drogue-iot/burrboard/hardware/feather/burrboard_back.png

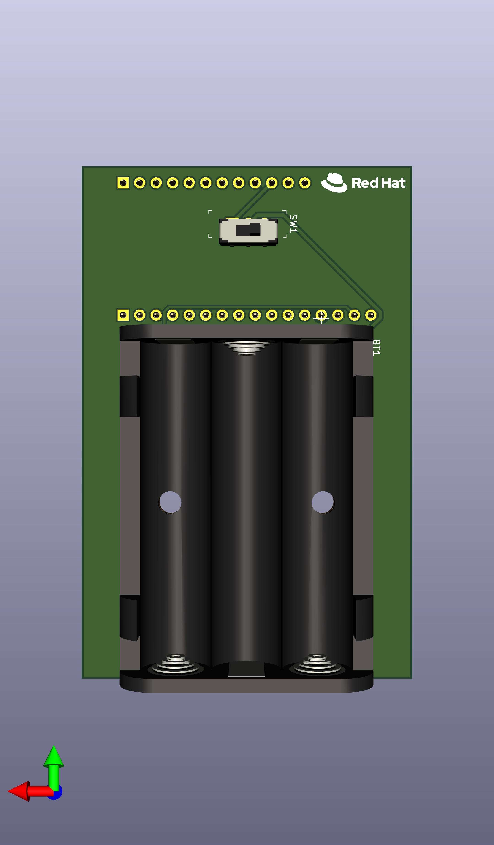
hardware/feather/burrboard_back.png
