drogue-iot/burrboard/hardware/feather/burrboard_front.png

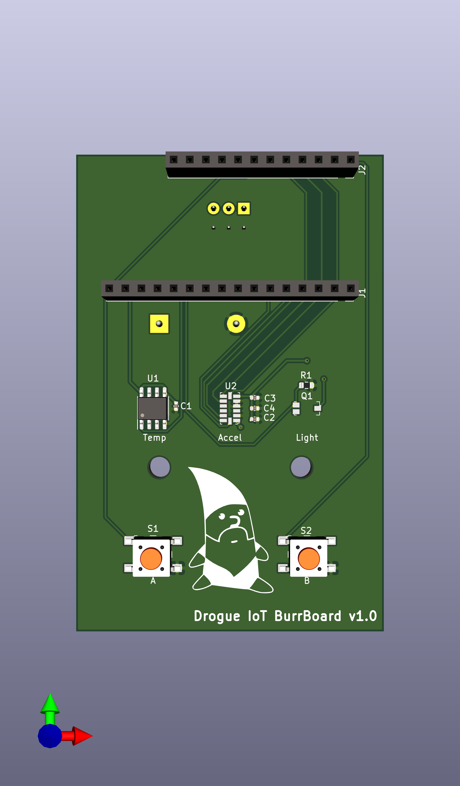
hardware/feather/burrboard_front.png
