drogue-iot/burrboard/README.md

# burrboard

This repository contains prototyping boards for RH summit, aka burrboards, firmware running on the
burrboard feathers, and the software around it
