drogue-iot/burrboard/digital-twin/README.md

# Cheatsheet

## Creating devices (for the simulator)

Requires drg >= 0.8.1 (alpha1)

```shell
drg create device -a ctron-test-ditto device1
drg set password -a ctron-test-ditto foobar1 device1
drg label device -a device1 ditto=true
```

Create a list of devices:

```shell
for i in $(seq -w 1 10); do
  drg create device -a ctron-test-ditto device$i
  drg set password -a ctron-test-ditto foobar$i device$i
  drg set label -a ctron-test-ditto --device device$i ditto=true
done
```

Delete them again:

```shell
for i in $(seq -w 1 10); do
  drg delete device -a ctron-test-ditto device$i
done
```

## Access data

```shell
USER="someuser"
PASSWORD="abc"
podman run --rm -ti docker.io/bitnami/kafka:latest kafka-console-consumer.sh \
	--topic sensor-events \
	--bootstrap-server kafka-kafka-bootstrap-burrboard.apps.wonderful.iot-playground.org:443 \
	--consumer-property security.protocol=SASL_SSL \
	--consumer-property sasl.mechanism=SCRAM-SHA-512 \
	--consumer-property sasl.jaas.config='org.apache.kafka.common.security.scram.ScramLoginModule required username="${USER}" password="${PASSWORD}";'
```

Also get the headers:

```shell
set TOPIC sensor-events
set USER "foo"
set PASSWORD (oc -n burrboard get secret $USER -o json | jq -r '.data.password' | base64 -d)
podman run --rm -it docker.io/edenhill/kcat:1.7.1 \
	-b kafka-kafka-bootstrap-burrboard.apps.wonderful.iot-playground.org:443 \
	-o end \
	-X security.protocol=SASL_SSL \
	-X sasl.mechanism=SCRAM-SHA-512 \
	-X sasl.username=$USER \
	-X sasl.password=$PASSWORD \
	-f '\nKey (%K bytes): %k
  Value (%S bytes): %s
  Timestamp: %T
  Partition: %p
  Offset: %o
  Headers: %h\n' \
	-G my-kafka-group $TOPIC
```

## Kafka stuff

List consumer groups:

```shell
./bin/kafka-consumer-groups.sh --bootstrap-server kafka-kafka-bootstrap-burrboard.apps.wonderful.iot-playground.org:443 --command-config config.properties --list
./bin/kafka-consumer-groups.sh --bootstrap-server drogue-iot-kafka-bootstrap-drogue-dev.apps.wonderful.iot-playground.org:443 --command-config config2.properties --list
```

Watch consumer groups:
```shell
watch "./bin/kafka-consumer-groups.sh --bootstrap-server kafka-kafka-bootstrap-burrboard.apps.wonderful.iot-playground.org:443 --command-config /home/jreimann/git/burrboard/digital-twin/config.properties --group ditto-reconciler --describe ; ./bin/kafka-consumer-groups.sh --bootstrap-server kafka-kafka-bootstrap-burrboard.apps.wonderful.iot-playground.org:443 --command-config /home/jreimann/git/burrboard/digital-twin/config.properties --group game-controller --describe ; ./bin/kafka-consumer-groups.sh --bootstrap-server drogue-iot-kafka-bootstrap-drogue-dev.apps.wonderful.iot-playground.org:443 --command-config /home/jreimann/git/burrboard/digital-twin/config2.properties --group ditto-kafka-drogue-ctron-test-ditto --describe"
```

## Work with digital twin

Get state:

```shell
set TOKEN (drg whoami -t)
http -v GET https://ditto-drogue-dev.apps.wonderful.iot-playground.org/api/2/things/ctron-test-ditto:device1 "Authorization:Bearer $TOKEN"
```

Request LED state:

```shell
set TOKEN (drg whoami -t)
http -v PUT https://ditto-drogue-dev.apps.wonderful.iot-playground.org/api/2/things/ctron-test-ditto:device1/features/leds "Authorization:Bearer $TOKEN" \
  --raw '{}'
http -v PUT https://ditto-drogue-dev.apps.wonderful.iot-playground.org/api/2/things/ctron-test-ditto:device1/features/leds/desiredProperties/1 "Authorization:Bearer $TOKEN" \
  --raw 'true'
```
