drogue-iot/burrboard/hardware/feather/burrboard.html

# /Users/lulf/dev/burrboard/feather/burrboard.sch

2022 January 07, Friday 11:13:08

Eeschema (5.1.10-1-10_14)

Component Count:14

Ref | Qnty | Value | Part | Datasheet | Description | Vendor
BT1 | 1 | 2479 | Device:Battery | https://www.keyelco.com/userAssets/file/M65p28.pdf | Multiple-cell battery
C1, C4 | 2 | 100.0nF, 0805 SMD | Device:CP1 | ~ | Polarized capacitor, US symbol
C2 | 1 | 10.0µF, 0805 SMD | Device:CP1 | ~ | Polarized capacitor, US symbol
C3 | 1 | 100.0nF, 0805 SMD | Device:CP1 | ~ | Polarized capacitor, US symbol
J1 | 1 | M20-7821642 | Connector_Generic:Conn_01x16 | ~ | Generic connector, single row, 01x16, script generated (kicad-library-utils/schlib/autogen/connector/)
J2 | 1 | M20-7821242 | Connector_Generic:Conn_01x12 | ~ | Generic connector, single row, 01x12, script generated (kicad-library-utils/schlib/autogen/connector/)
Q1 | 1 | TEMT6000X01 | dk_Optical-Sensors-Phototransistors:TEMT6000X01 | http://www.vishay.com/docs/81579/temt6000.pdf | SENSOR PHOTO 570NM TOP VIEW 1206
R1 | 1 | Resistor, 10.0kΩ, 0805 SMD | Device:R | ~ | Resistor
S1, S2 | 2 | PTS645SH43SMTR92LFS | dk_Tactile-Switches:PTS645SM43SMTR92_LFS | https://www.ckswitches.com/media/1471/pts645.pdf | SWITCH TACTILE SPST-NO 0.05A 12V
S3 | 1 | JS202011SCQN | burrboard:JS202011SCQN | https://www.ckswitches.com/media/1422/js.pdf | SWITCH SLIDE DPDT 300MA 6V
U1 | 1 | TMP36GSZ | Sensor_Temperature:TMP36xS | https://www.analog.com/media/en/technical-documentation/data-sheets/TMP35_36_37.pdf | Low Voltage Temperature Sensor, SOIC-8
U2 | 1 | ADXL345BCCZ | dk_Motion-Sensors-Accelerometers:ADXL345BCCZ | https://www.analog.com/media/en/technical-documentation/data-sheets/ADXL345.pdf | ACCEL 2-16G I2C/SPI 14LGA
