drogue-iot/burrboard/hardware/microbit/burrboard.html

# /Users/lulf/dev/burrboard/burrboard.sch

2021 December 20, Monday 12:28:43

Eeschema (5.1.10-1-10_14)

Component Count:14

Ref | Qnty | Value | Part | Datasheet | Description | Vendor
BT1, BT2, BT3 | 3 | Battery_Cell | Device:Battery_Cell | ~ | Single-cell battery
J1 | 1 | 22-23-2021 | dk_Rectangular-Connectors-Headers-Male-Pins:22-23-2021 | https://media.digikey.com/pdf/Data%20Sheets/Molex%20PDFs/A-6373-N_Series_Dwg_2010-12-03.pdf | CONN HEADER VERT 2POS 2.54MM
J2 | 1 | microbit_edge_connector | microbit_edge_connector:microbit_edge_connector | https://www.microbit.co.uk/device/pins | micro:bit vertial edge connector
J3 | 1 | TEMP | Connector_Generic:Conn_01x01 | ~ | Generic connector, single row, 01x01, script generated (kicad-library-utils/schlib/autogen/connector/)
J4 | 1 | SPI | Connector_Generic:Conn_01x03 | ~ | Generic connector, single row, 01x03, script generated (kicad-library-utils/schlib/autogen/connector/)
J5 | 1 | Light | Connector_Generic:Conn_01x01 | ~ | Generic connector, single row, 01x01, script generated (kicad-library-utils/schlib/autogen/connector/)
J6 | 1 | Power | Connector_Generic:Conn_02x02_Top_Bottom | ~ | Generic connector, double row, 02x02, top/bottom pin numbering scheme (row 1: 1...pins_per_row, row2: pins_per_row+1 ... num_pins), script generated (kicad-library-utils/schlib/autogen/connector/)
J7 | 1 | Conn_01x06 | Connector_Generic:Conn_01x06 | ~ | Generic connector, single row, 01x06, script generated (kicad-library-utils/schlib/autogen/connector/)
J8 | 1 | I2C | Connector_Generic:Conn_01x02 | ~ | Generic connector, single row, 01x02, script generated (kicad-library-utils/schlib/autogen/connector/)
Q1 | 1 | Q_Photo_NPN | Device:Q_Photo_NPN | ~ | NPN phototransistor, collector/emitter
R1 | 1 | 2k | Device:R | ~ | Resistor
U1 | 1 | TMP36GT9Z | dk_Temperature-Sensors-Analog-and-Digital-Output:TMP36GT9Z | https://www.analog.com/media/en/technical-documentation/data-sheets/TMP35_36_37.pdf | SENSOR ANALOG -40C-125C TO92-3
