drogue-iot/burrboard/hardware/back.png

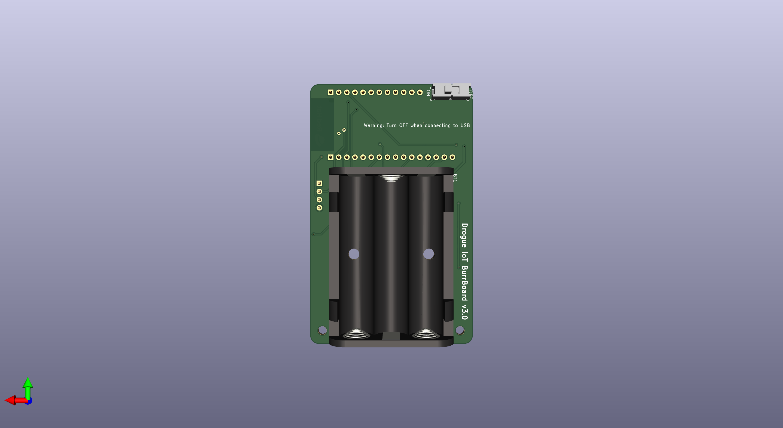
hardware/back.png
