drogue-iot/burrboard/hardware/redhat.png

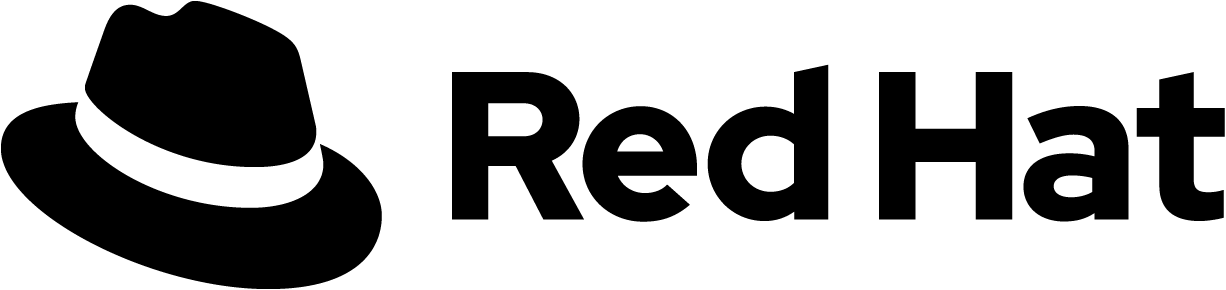
hardware/redhat.png
