drogue-iot/burrboard/hardware/side.png

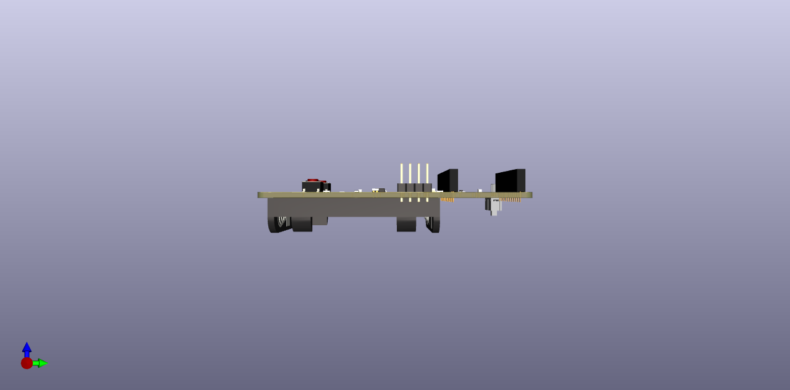
hardware/side.png
