drogue-iot/burrboard/hardware/feather/3dmodels/ADXL345BCCZ-RL7.stp

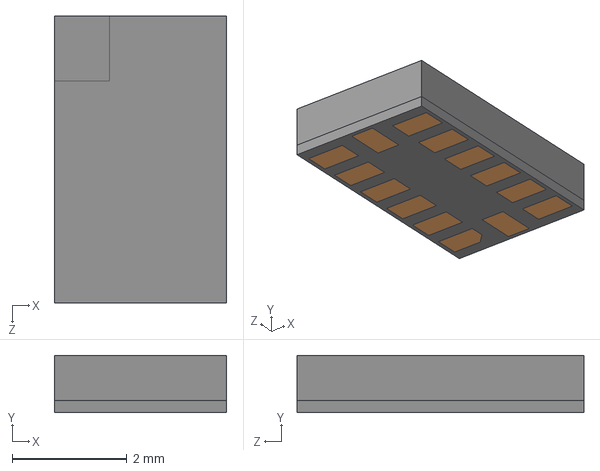
[picture p6: CAD file, 2022-02-15]
hardware/feather/3dmodels/ADXL345BCCZ-RL7.stp
3.00 x 1.00 x 5.00 mm
