drogue-iot/burrboard/hardware/feather/3dmodels/TEMT6000X01.stp

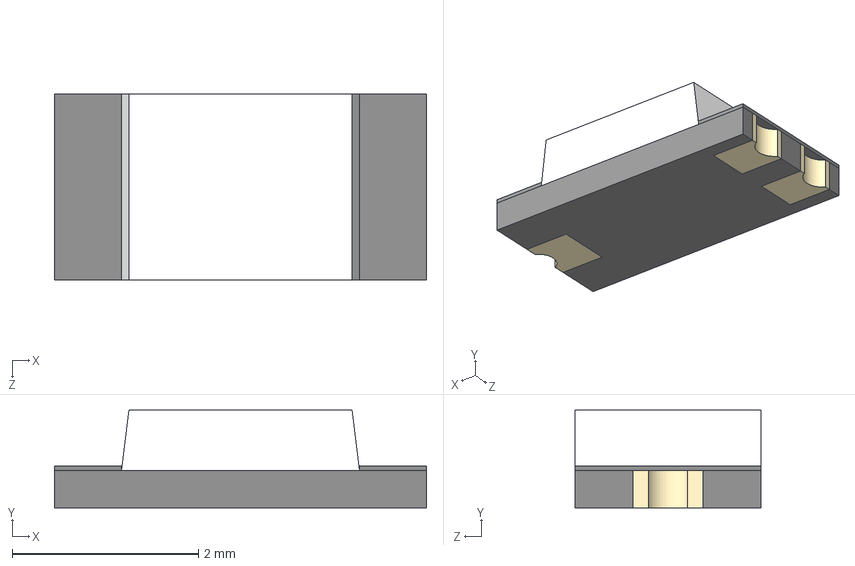
[picture p7: CAD file, 2022-02-02]
hardware/feather/3dmodels/TEMT6000X01.stp
4.00 x 1.05 x 2.00 mm
