drogue-iot/burrboard/hardware/feather/3dmodels/EG1218--3DModel-STEP-520916.STEP

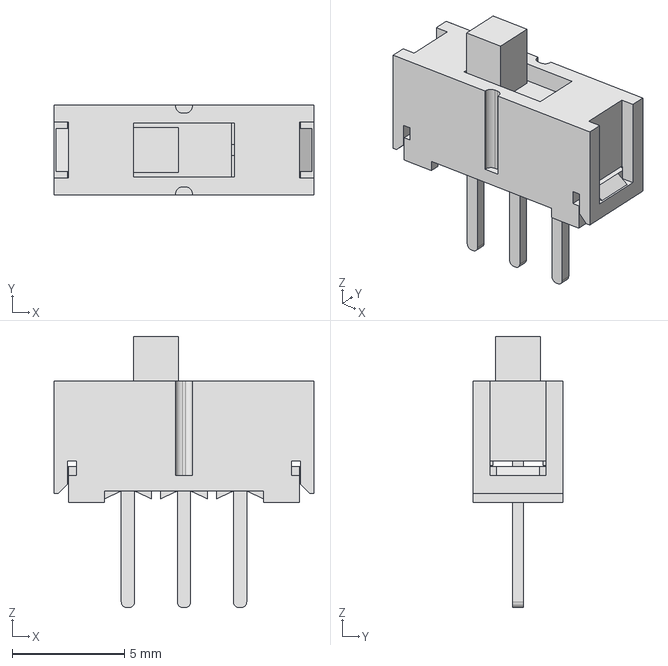
[picture p8: CAD file, 2022-02-02]
hardware/feather/3dmodels/EG1218--3DModel-STEP-520916.STEP
11.6 x 4.00 x 12.1 mm
