drogue-iot/burrboard/hardware/feather/assembly_drawings/3d_back.png

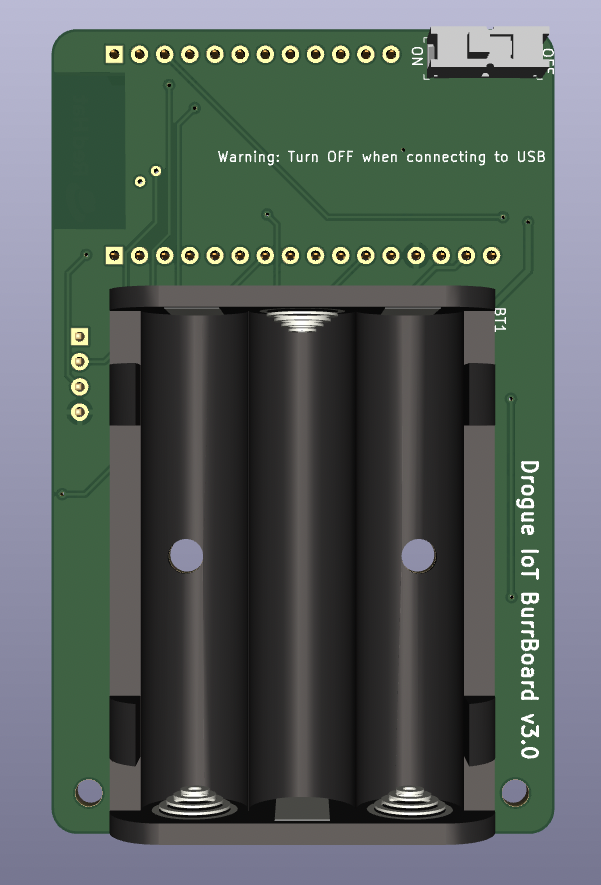
hardware/feather/assembly_drawings/3d_back.png
