drogue-iot/burrboard/hardware/feather/assembly_drawings/3d_front.png

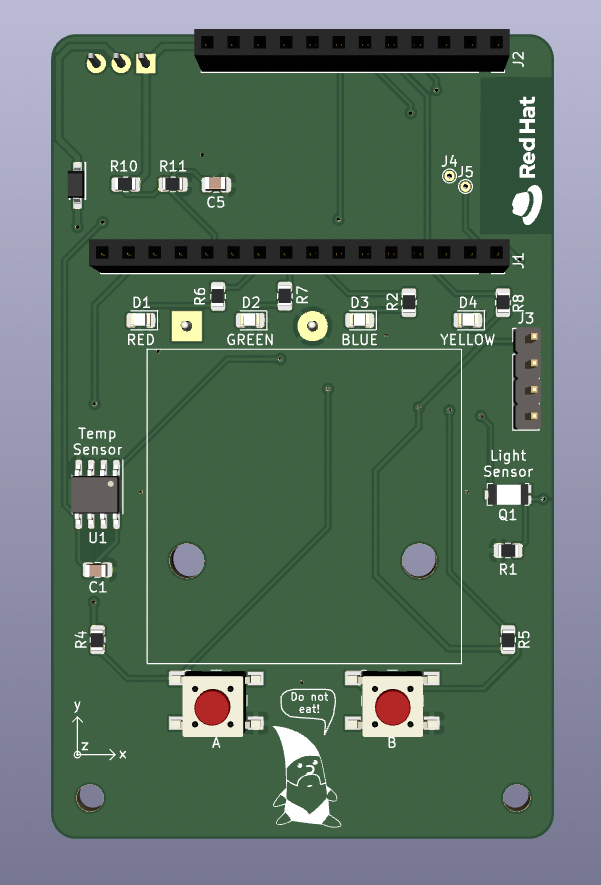
hardware/feather/assembly_drawings/3d_front.png
