drogue-iot/burrboard/hardware/feather/assembly_drawings/assembly_drawing.pdf

## Front Side

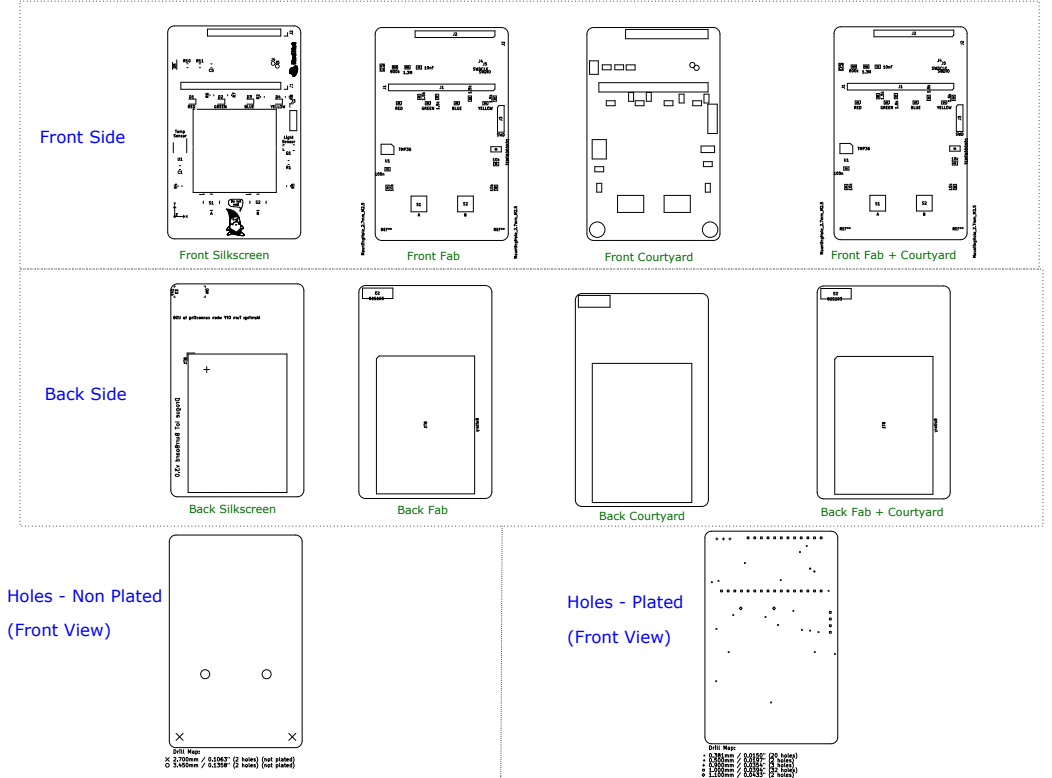
[picture p11: page 1]
Front Silkscreen; Front Fab; Front Courtyard; Front Fab + Courtyard; Back Silkscreen; Back Side; Holes - Plated; (Front View); Back Fab; Back Courtyard; Back Fab + Courtyard

Holes - Non Plated
(Front View)
