drogue-iot/burrboard/(commit log)

2022-01-03 Initial import
    [burrboard.kicad_pcb, burrboard.sch]
2022-01-03 Use AAA holder
    [burrboard.sch]
2022-01-03 Update capacitor dimensions
    [burrboard.sch]
2022-01-03 Add new footprint
2022-01-03 ADd footprint for 40p microbit connector SMD mount
2022-01-04 Add feather variant
    [burrboard.kicad_pcb, burrboard.sch]
2022-01-04 Add new phototransistor and button
    [burrboard.sch]
2022-01-04 Use THT transistor in prototype
    [burrboard.sch]
2022-01-04 Add initial pcb layout
    [burrboard.kicad_pcb, burrboard.sch]
2022-01-04 Add layout
    [burrboard.kicad_pcb]
2022-01-04 Add logo
    [burrboard.kicad_pcb]
2022-01-05 Add redhat logo to back silkscreen
    * More place route
    [burrboard.kicad_pcb, burrboard.sch]
2022-01-05 Update to handle battery case
    [burrboard.kicad_pcb, burrboard.sch]
2022-01-05 Place accelerometer on main part
    [burrboard.kicad_pcb, burrboard.sch]
2022-01-05 Layout done
    [burrboard.kicad_pcb, burrboard.sch]
2022-01-05 Add gerber files
    [burrboard-B_Cu.gbl, burrboard-B_Mask.gbs, burrboard-B_SilkS.gbo, burrboard-Edge_Cuts.gm1, burrboard-F_Cu.gtl, burrboard-F_Mask.gts, burrboard-F_SilkS.gto, burrboard-job.gbrjob]
2022-01-05 Update gerbers
    [burrboard-B_Cu.gbl, burrboard-B_Mask.gbs, burrboard-B_SilkS.gbo, burrboard-Edge_Cuts.gm1, burrboard-F_Cu.gtl, burrboard-F_Mask.gts, burrboard-F_SilkS.gto, burrboard-job.gbrjob]
2022-01-05 Update 3d modesl
    [burrboard-B_Cu.gbl, burrboard-B_Mask.gbs, burrboard-B_SilkS.gbo, burrboard-Edge_Cuts.gm1, burrboard-F_Cu.gtl, burrboard-F_Mask.gts, burrboard-F_SilkS.gto, burrboard-job.gbrjob]
2022-01-05 Update part values
    [burrboard.sch]
2022-01-06 Adjust silkscreen
    [burrboard-B_Cu.gbl, burrboard-B_Mask.gbs, burrboard-B_SilkS.gbo, burrboard-Edge_Cuts.gm1, burrboard-F_Cu.gtl, burrboard-F_Mask.gts, burrboard-F_SilkS.gto, burrboard-job.gbrjob]
2022-01-06 Update manufacturer
    [burrboard-B_Cu.gbl, burrboard-B_Mask.gbs, burrboard-B_SilkS.gbo, burrboard-Edge_Cuts.gm1, burrboard-F_Cu.gtl, burrboard-F_Mask.gts, burrboard-F_SilkS.gto, burrboard-job.gbrjob]
2022-01-06 Use larger capacitor and resistor prints
    [burrboard-B_Cu.gbl, burrboard-B_Mask.gbs, burrboard-B_SilkS.gbo, burrboard-Edge_Cuts.gm1, burrboard-F_Cu.gtl, burrboard-F_Mask.gts, burrboard-F_SilkS.gto, burrboard-job.gbrjob]
2022-01-06 Use larger footprints for capacitors and resistors
    [burrboard-B_Cu.gbl, burrboard-B_Mask.gbs, burrboard-B_SilkS.gbo, burrboard-Edge_Cuts.gm1, burrboard-F_Cu.gtl, burrboard-F_Mask.gts, burrboard-F_SilkS.gto, burrboard-job.gbrjob]
2022-01-06 Update specs
    [burrboard.sch]
2022-01-07 Update to use DPDT SMD switch
    [burrboard-B_Cu.gbl, burrboard-B_Mask.gbs, burrboard-B_SilkS.gbo, burrboard-Edge_Cuts.gm1, burrboard-F_Cu.gtl, burrboard-F_Mask.gts, burrboard-F_SilkS.gto, burrboard-job.gbrjob]
2022-01-07 Move switch and add pin header
    [burrboard-B_Cu.gbl, burrboard-B_Mask.gbs, burrboard-B_SilkS.gbo, burrboard-Edge_Cuts.gm1, burrboard-F_Cu.gtl, burrboard-F_Mask.gts, burrboard-F_SilkS.gto, burrboard-job.gbrjob]
2022-01-10 Add accelerometer to test
2022-01-11 Add status LEDs and switch to i2c for accel
    [burrboard.kicad_pcb, burrboard.sch]
2022-01-12 Update schematic with LEDs
    [burrboard.sch]
2022-01-12 Complete schematic
    [burrboard.sch]
2022-01-13 Update resistor values
    [burrboard.sch]
2022-01-13 Rev 2.0
    [burrboard-B_Cu.gbl, burrboard-B_Mask.gbs, burrboard-B_SilkS.gbo, burrboard-Edge_Cuts.gm1, burrboard-F_Cu.gtl, burrboard-F_Mask.gts, burrboard-F_SilkS.gto, burrboard-job.gbrjob]
2022-01-13 Update refs
    [burrboard-B_Cu.gbl, burrboard-B_Mask.gbs, burrboard-B_SilkS.gbo, burrboard-Edge_Cuts.gm1, burrboard-F_Cu.gtl, burrboard-F_Mask.gts, burrboard-F_SilkS.gto, burrboard-job.gbrjob]
2022-01-14 Switch orientation of accel and add silkscreen of orientation
    [burrboard-B_Cu.gbl, burrboard-B_Mask.gbs, burrboard-B_SilkS.gbo, burrboard-Edge_Cuts.gm1, burrboard-F_Cu.gtl, burrboard-F_Mask.gts, burrboard-F_SilkS.gto, burrboard-job.gbrjob]
2022-01-15 Update part descriptions
    [burrboard-B_Cu.gbl, burrboard-B_Mask.gbs, burrboard-B_SilkS.gbo, burrboard-Edge_Cuts.gm1, burrboard-F_Cu.gtl, burrboard-F_Mask.gts, burrboard-F_SilkS.gto, burrboard-job.gbrjob]
2022-01-15 Add stuff
    [burrboard.kicad_pcb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]
2022-01-17 Add BOM
    [burrboard.csv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]
2022-01-17 Update temt footprint
    [burrboard.kicad_sch]
2022-01-17 Add kicad sym
2022-01-17 Fix symbols
    [burrboard.kicad_sch]
2022-01-17 Final fixes
    [burrboard.kicad_pcb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]
2022-01-17 Add led names
    [burrboard.kicad_pcb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]
2022-01-17 Add missing names
    [burrboard.csv, burrboard.kicad_pcb, burrboard.kicad_sch]
2022-01-18 Move hardware folder
    [burrboard-B_Cu.gbl, burrboard-B_Mask.gbs, burrboard-B_SilkS.gbo, burrboard-Edge_Cuts.gm1, burrboard-F_Cu.gtl, burrboard-F_Mask.gts, burrboard-F_SilkS.gto, burrboard-job.gbrjob]
2022-01-18 Initial work on uart logger
2022-01-18 Rotate accelerometer to match sense
    [burrboard.kicad_pcb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]
2022-01-19 Add support for entering OTA DFU pressing user button
2022-01-22 Enable buttons and leds in test app
2022-01-25 feat: rename properties to match button names
2022-01-25 feat: extend device simulation
    Add additional sensors and actors.
2022-01-25 Rework design
    [burrboard.kicad_pcb, burrboard.kicad_sch]
2022-01-26 Make space for QR code
    [burrboard.kicad_pcb, burrboard.kicad_sch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]
2022-01-26 Update 3d rendering
    [burrboard.csv]
2022-01-26 New layout
    [burrboard.kicad_pcb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]
2022-01-27 Update build to latest embassy/drogue-device
2022-01-27 Increase rodney size
    [burrboard.kicad_pcb]
2022-01-27 feat: use new led handling
2022-01-27 fix: report back LED state after updating internally
2022-01-28 docs: add some instructions on how to create more devices
2022-01-29 Update hardware
    [burrboard-B_Cu.gbl, burrboard-B_Mask.gbs, burrboard-B_SilkS.gbo, burrboard-Edge_Cuts.gm1, burrboard-F_Cu.gtl, burrboard-F_Mask.gts, burrboard-F_SilkS.gto, burrboard-job.gbrjob]
2022-01-29 Add actors for all sensors
2022-01-31 Don't commit gerbers
    [burrboard-B_Cu.gbl, burrboard-B_Mask.gbs, burrboard-Edge_Cuts.gm1, burrboard-F_Cu.gtl, burrboard-F_Mask.gts, burrboard-job.gbrjob, burrboard.drl]
2022-02-01 Add GATT implementation of device
2022-02-01 Add accelerometer as optional
2022-02-01 Make accelerometer optional
2022-02-02 Add changes to rev3
    [burrboard.csv, burrboard.kicad_pcb, burrboard.kicad_sch]
2022-02-02 Move switch
    [burrboard.kicad_pcb]
2022-02-02 Add 3d models
    [EG1218--3DModel-STEP-520916.STEP, TEMT6000X01.stp, burrboard.kicad_pcb]
2022-02-02 Add new renderings
    [burrboard.kicad_pcb]
2022-02-02 Add streaming of sensor data
2022-02-02 Stream all sensor values
2022-02-02 Add LED command support
2022-02-03 Add mounting holes
    [burrboard.kicad_pcb]
2022-02-04 Update board
    [burrboard.kicad_pcb, burrboard.kicad_sch]
2022-02-07 Add schottky diode
    [burrboard.kicad_pcb, burrboard.kicad_sch]
2022-02-10 Update schottky footprint
    [burrboard.kicad_pcb]
2022-02-10 Move keepout zone
    [burrboard.kicad_pcb]
2022-02-11 Use DFU actor from -device
2022-02-15 Snapshot of deliverables
    [burrboard-B_Courtyard.gbr, burrboard-B_Cu.gbl, burrboard-B_Fab.gbr, burrboard-B_Mask.gbs, burrboard-B_Paste.gbp, burrboard-B_Silkscreen.gbo, burrboard-Edge_Cuts.gm1, burrboard-F_Courtyard.gbr]
2022-02-15 Rev 3.5
    [burrboard.kicad_pcb, burrboard.kicad_sch]
2022-02-15 Add 3d model for XL
    [ADXL345BCCZ-RL7.stp, burrboard.kicad_pcb]
2022-02-16 Add generic battery server
2022-02-16 Get rid of ButtonDriver
2022-02-16 Refactor app so that one can switch between MESH and GATT mode at runtime
2022-02-17 Refactor and add different led patterns
2022-02-17 Rev 4
    [burrboard.kicad_pcb, burrboard.kicad_sch]
2022-02-18 Update pin numbering
2022-02-21 Increase size of pogopin footprint
    [burrboard.kicad_pcb, burrboard.kicad_sch]
2022-02-21 Move files
    [burrboard-B_Courtyard.gbr, burrboard-B_Cu.gbl, burrboard-B_Fab.gbr, burrboard-B_Mask.gbs, burrboard-B_Paste.gbp, burrboard-B_Silkscreen.gbo, burrboard-Edge_Cuts.gm1, burrboard-F_Courtyard.gbr]
2022-02-21 doc: update LED command too
2022-02-21 fix: wrap led state property
2022-02-21 fix: internal led state
2022-02-22 Use new sensor model
2022-02-23 Publish sensor data
2022-02-24 Support multiple board revisions
2022-02-24 Report normalized accelerometer data
2022-02-24 Update accelerometer data
2022-02-24 Update accelerometer value data
2022-02-24 Use remote drogue-device
2022-02-24 Switch to correct format
    [board.rs, main.rs]
2022-02-25 Add LEDs to report
2022-02-25 Add leds to gatt service
2022-02-25 Use a single characteristic for sensor payload
2022-03-02 refactor: send full state of the device
2022-03-04 Make rev 3.5 final version
    [burrboard-B_Courtyard.gbr, burrboard-B_Cu.gbl, burrboard-B_Fab.gbr, burrboard-B_Mask.gbs, burrboard-B_Paste.gbp, burrboard-B_Silkscreen.gbo, burrboard-Edge_Cuts.gm1, burrboard-F_Courtyard.gbr]
2022-03-04 Update silkscreen on the back side
    [burrboard-B_Courtyard.gbr, burrboard-B_Cu.gbl, burrboard-B_Fab.gbr, burrboard-B_Mask.gbs, burrboard-B_Paste.gbp, burrboard-B_Silkscreen.gbo, burrboard-Edge_Cuts.gm1, burrboard-F_Courtyard.gbr]
2022-03-04 Update schematic version
    [burrboard.kicad_pcb, burrboard.kicad_sch]
2022-03-07 Ensure accelerometer is powered on and ready before initializing
2022-03-07 Add current button state to gatt and mesh models
2022-03-07 fix: try reducing compiler warnings
    [board.rs, main.rs]
2022-03-07 Update to latest drogue-device
2022-03-08 Minor doc changes to line up with the current code
2022-03-10 Introduce sensor value parsing logic and clean up the code a bit
2022-03-10 Implement burrboard sensor model
2022-03-10 Represent led and button state in a single byte
2022-03-11 Patch ADXL driver with 345 fix
2022-03-14 Update component
    [burrboard.kicad_pcb, burrboard.kicad_sch]
2022-03-14 Update to new drogue device
    * Add status report of battery level
2022-03-14 Use committed -device
2022-03-29 Support running without accelerometer
2022-03-30 Make it possible to disable sensors
2022-03-31 Update to use firmware DFU protocol from drogue device
2022-03-31 Fix rev 3.5 build
    [accel.rs]
2022-03-31 Update device rev
2022-04-12 Add onoff model to switch mode remotely
2022-04-12 Update drogue device version
2022-04-19 Update drogue device revision
2022-04-26 Minor doc fixes due to recent changes
    Specifically new dir structure, name conflicts and dbus dir mounting.
2022-04-28 The equivalent of the README example in k8s
    Getting evicted due to node-pressure, for some reason.
    Also need to unhardcode the paths in here.
2022-07-01 Add simple temperature sensor simulator device
