drogue-iot/burrboard/(notices)

Notices in the files:
hardware/feather/burrboard.sch:
License: Apache 2.0
